alexBinos/ergonomic_split/README.md

# ergonomic_split
An ergonomic split keyboard
