alexBinos/ergonomic_split/Mechanical/DXF/ergonomic_split_right-B_CrtYd.dxf

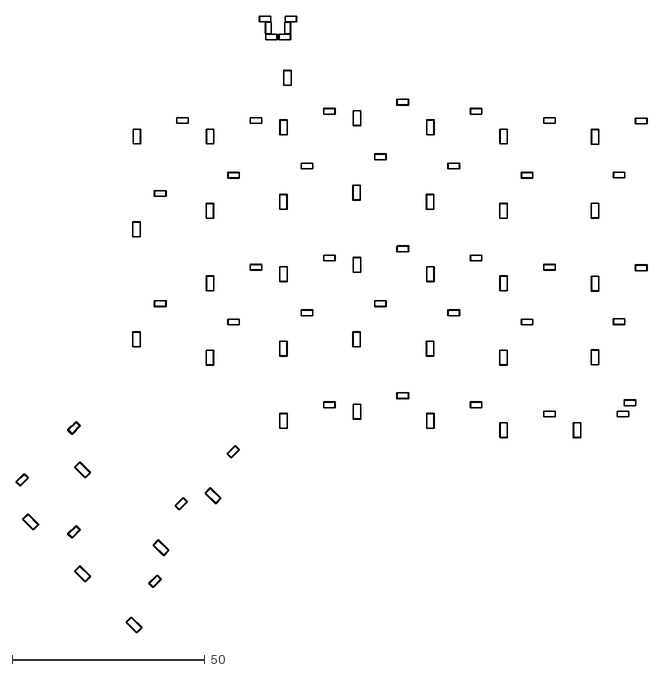
[picture p1: CAD file, 2022-08-09]
Mechanical/DXF/ergonomic_split_right-B_CrtYd.dxf
163.8 x 160.1
