alexBinos/ergonomic_split/Mechanical/left/ergonomic_split_left_key_frame.STL

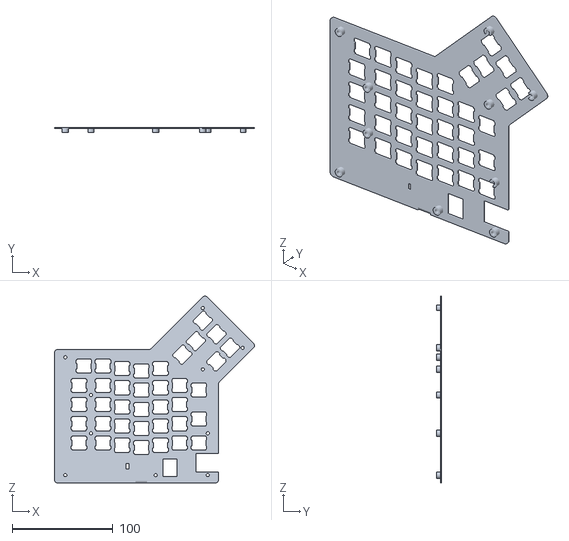
[picture p2: CAD file, 2022-08-22]
Mechanical/left/ergonomic_split_left_key_frame.STL
198.7 x 5.00 x 185.6
