alexBinos/ergonomic_split/Mechanical/switch.DXF

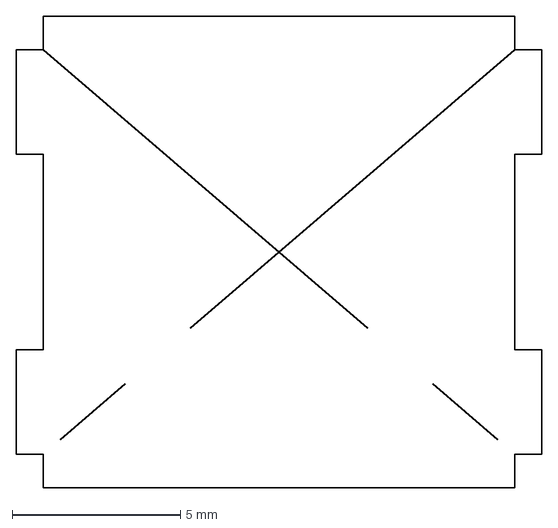
[picture p3: CAD file, 2022-08-06]
Mechanical/switch.DXF
15.6 x 14.0 mm
