alexBinos/ergonomic_split/Mechanical/DXF/ergonomic_split_right-PTH-drl_map.dxf

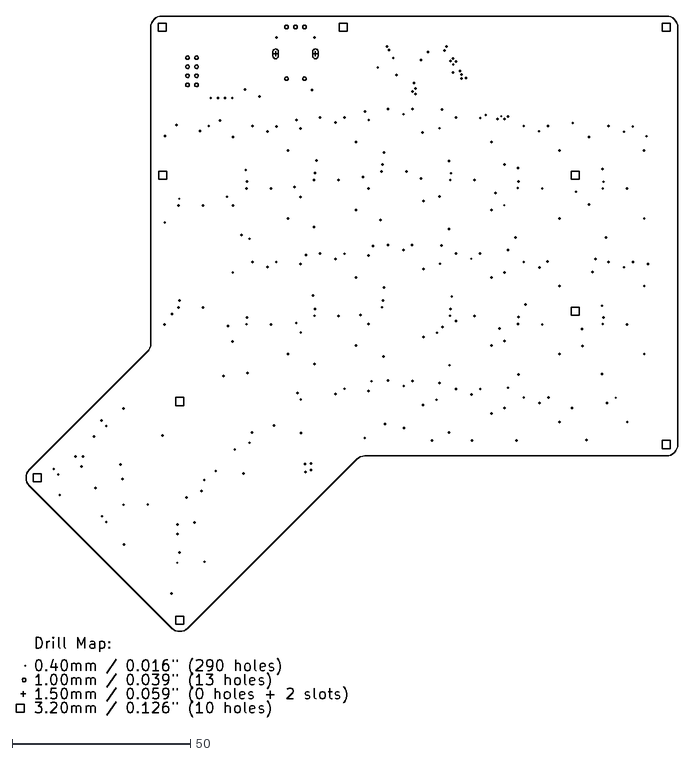
[picture p4: CAD file, 2022-08-09]
Mechanical/DXF/ergonomic_split_right-PTH-drl_map.dxf
185.7 x 196.8
