alexBinos/ergonomic_split/Mechanical/ergonomic_split_stand.STL

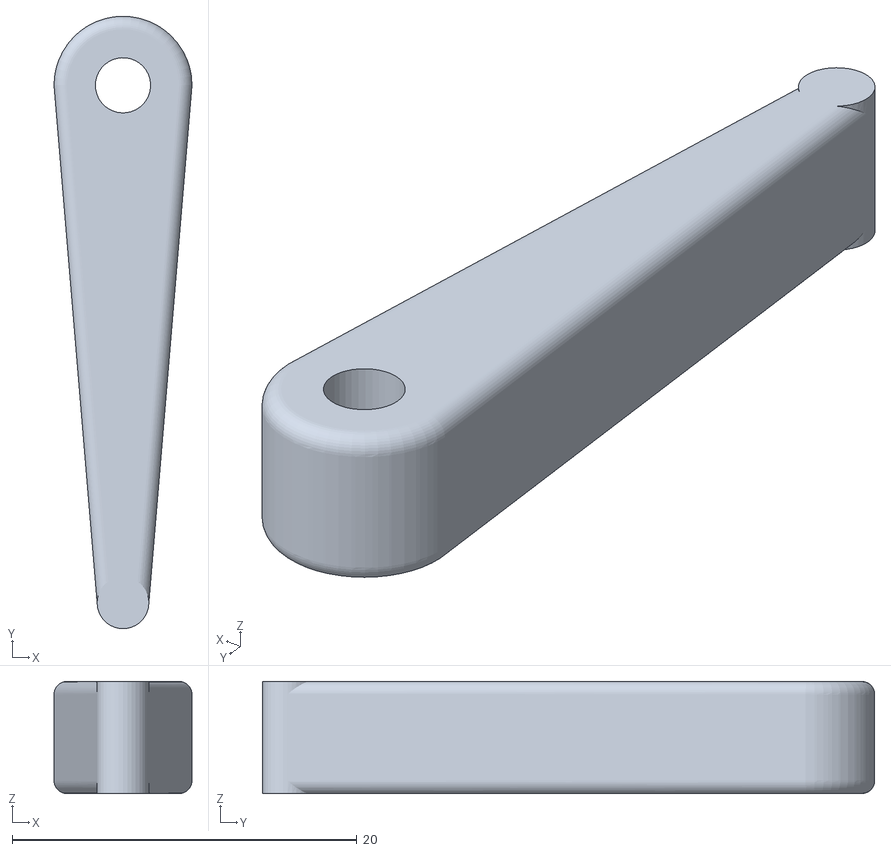
[picture p5: CAD file, 2022-08-06]
Mechanical/ergonomic_split_stand.STL
8.00 x 35.5 x 6.50
