alexBinos/ergonomic_split/Mechanical/left/ergonomic_split_left_case.STL

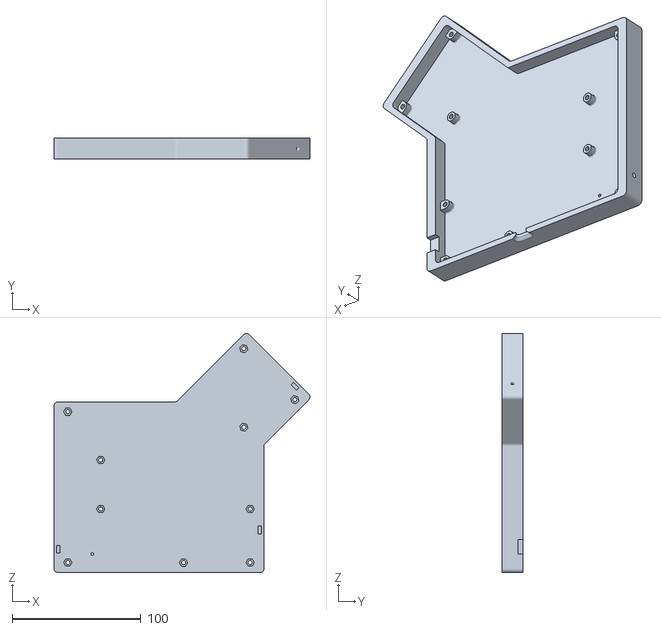
[picture p6: CAD file, 2022-08-13]
Mechanical/left/ergonomic_split_left_case.STL
198.7 x 16.0 x 185.6
