alexBinos/ergonomic_split/Mechanical/DXF/ergonomic_split_right-F_CrtYd.dxf

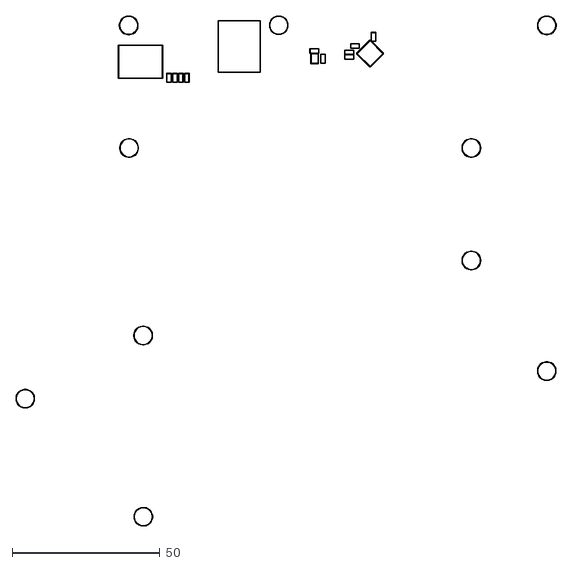
[picture p7: CAD file, 2022-08-09]
Mechanical/DXF/ergonomic_split_right-F_CrtYd.dxf
182.9 x 172.7
