alexBinos/ergonomic_split/Mechanical/DXF/ergonomic_split_right-Dwgs_User.dxf

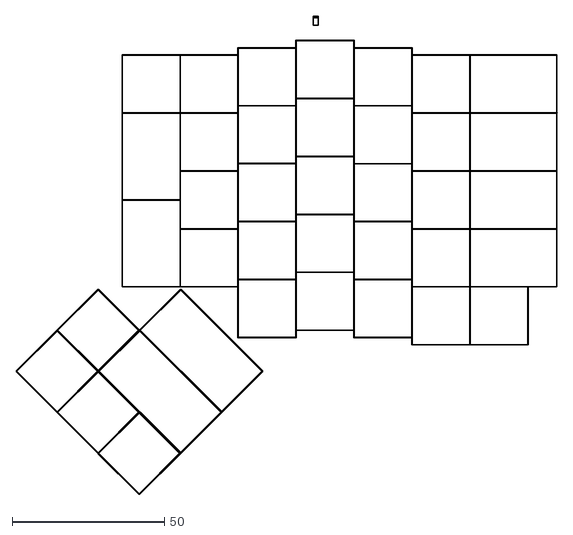
[picture p8: CAD file, 2022-08-09]
Mechanical/DXF/ergonomic_split_right-Dwgs_User.dxf
177.9 x 157.2
