alexBinos/ergonomic_split/Mechanical/DXF/ergonomic_split_right-Edge_Cuts.dxf

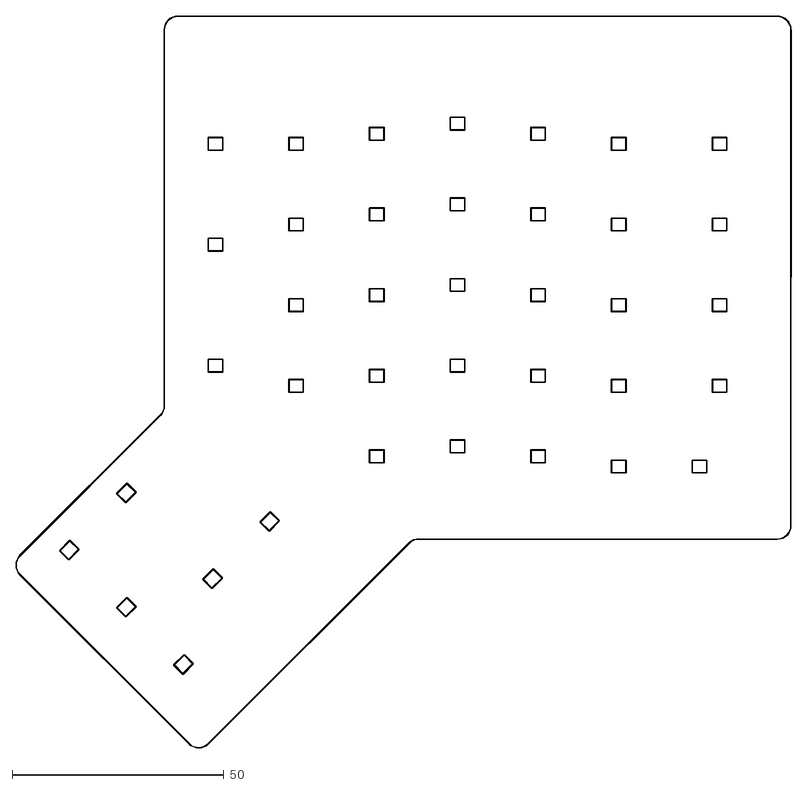
[picture p9: CAD file, 2022-08-09]
Mechanical/DXF/ergonomic_split_right-Edge_Cuts.dxf
183.0 x 172.8
