alexBinos/ergonomic_split/Mechanical/DXF/ergonomic_split_right-NPTH-drl_map.dxf

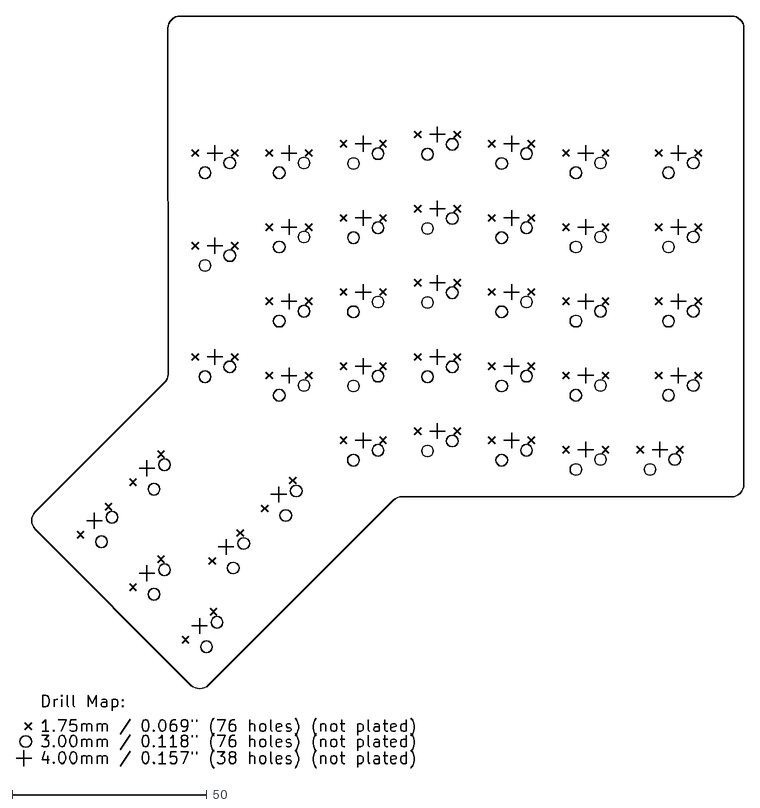
[picture p10: CAD file, 2022-08-09]
Mechanical/DXF/ergonomic_split_right-NPTH-drl_map.dxf
187.0 x 193.2
