alexBinos/ergonomic_split/Mechanical/DXF/ergonomic_split_left-F_CrtYd.dxf

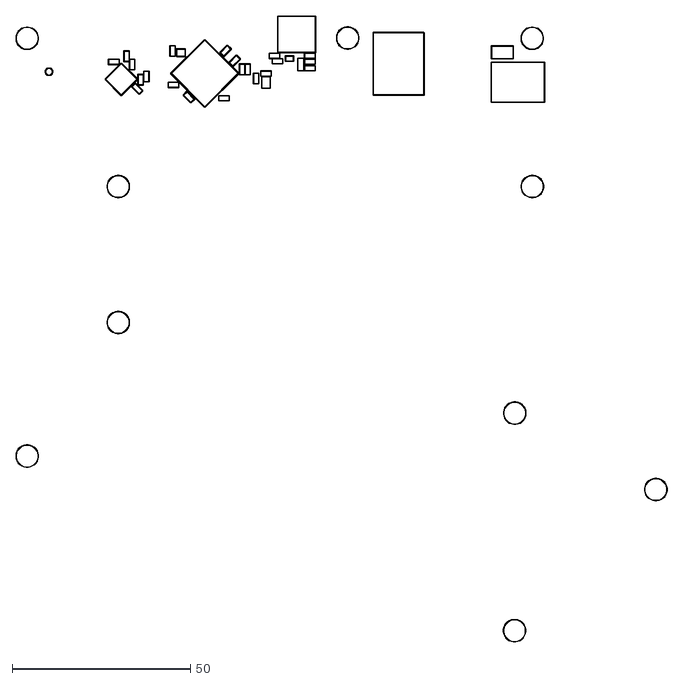
[picture p11: CAD file, 2022-07-26]
Mechanical/DXF/ergonomic_split_left-F_CrtYd.dxf
182.5 x 175.4
