alexBinos/ergonomic_split/Mechanical/DXF/ergonomic_split_left-PTH-drl_map.dxf

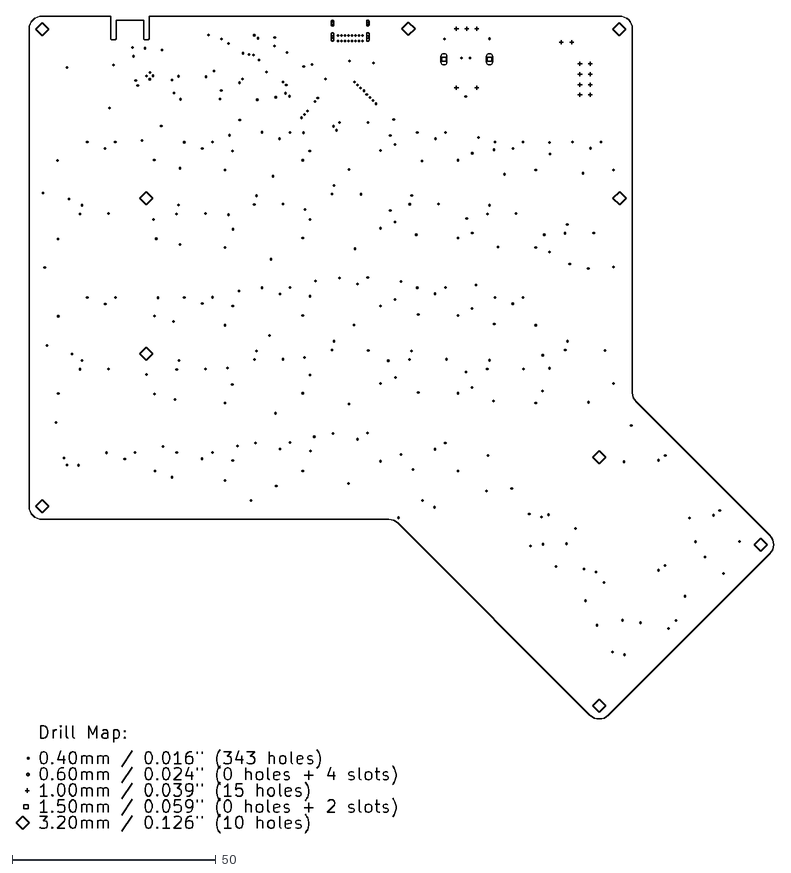
[picture p12: CAD file, 2022-07-26]
Mechanical/DXF/ergonomic_split_left-PTH-drl_map.dxf
186.1 x 200.4
