alexBinos/ergonomic_split/Mechanical/DXF/ergonomic_split_left-B_CrtYd.dxf

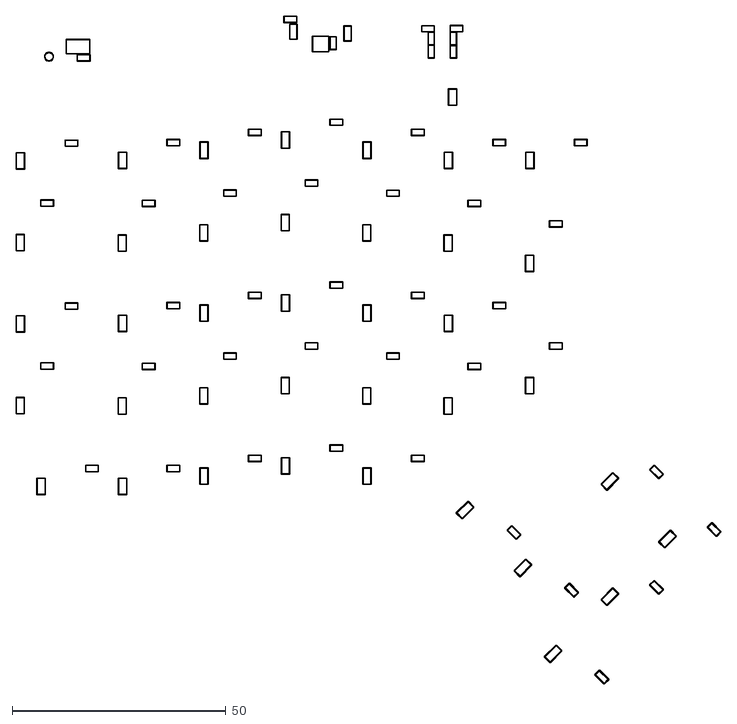
[picture p13: CAD file, 2022-07-26]
Mechanical/DXF/ergonomic_split_left-B_CrtYd.dxf
164.9 x 156.2
