alexBinos/ergonomic_split/Mechanical/DXF/ergonomic_split_left-NPTH-drl_map.dxf

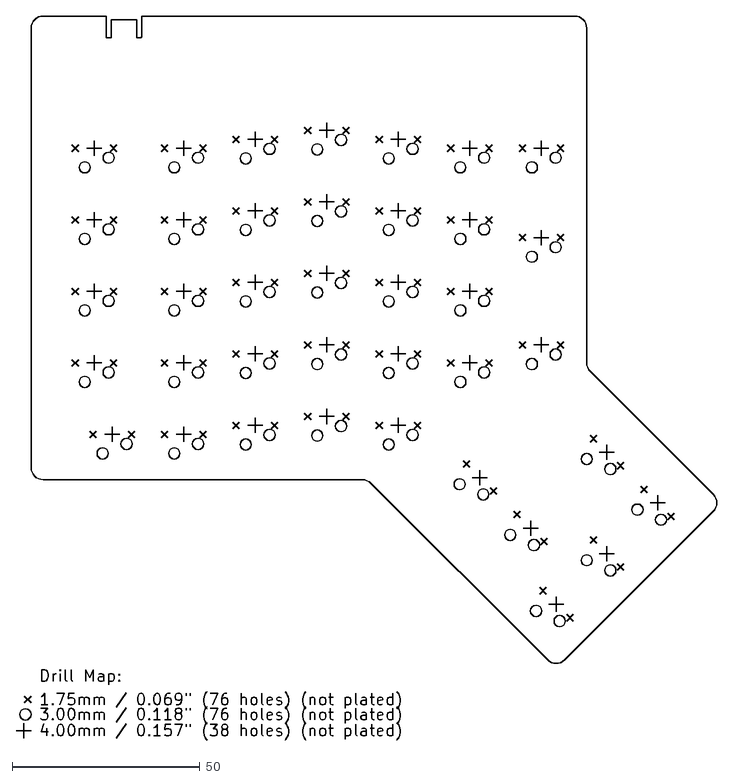
[picture p14: CAD file, 2022-07-26]
Mechanical/DXF/ergonomic_split_left-NPTH-drl_map.dxf
186.9 x 192.8
