alexBinos/ergonomic_split/Mechanical/DXF/ergonomic_split_left-Edge_Cuts.dxf

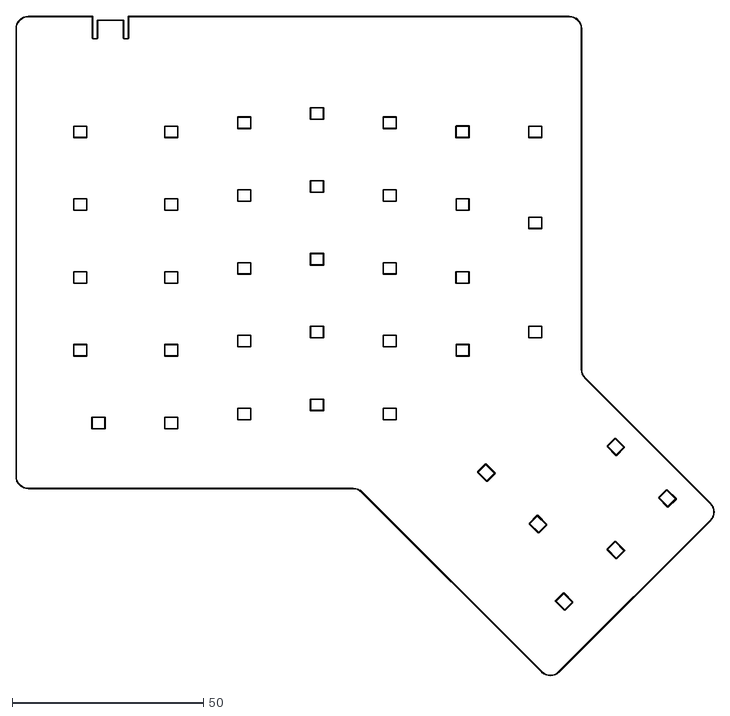
[picture p15: CAD file, 2022-07-26]
Mechanical/DXF/ergonomic_split_left-Edge_Cuts.dxf
182.6 x 172.5
