alexBinos/ergonomic_split/Mechanical/DXF/ergonomic_split_left-Dwgs_User.dxf

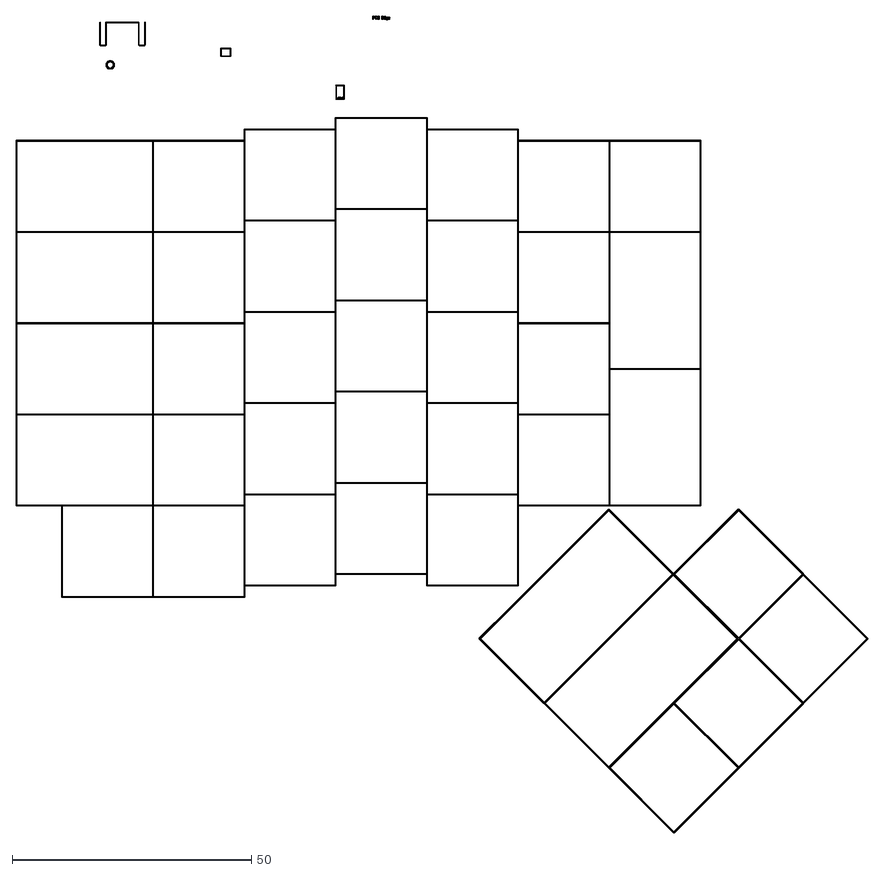
[picture p16: CAD file, 2022-07-26]
Mechanical/DXF/ergonomic_split_left-Dwgs_User.dxf
177.9 x 170.5
