alexBinos/ergonomic_split/(list of files, cad)

Other CAD files:
Mechanical/right/ergonomic_split_right_keyframe.STL
Mechanical/right/ergonomic_split_right_case.STL
