alexBinos/ergonomic_split/Documents/egonomic_split_right_sch.pdf

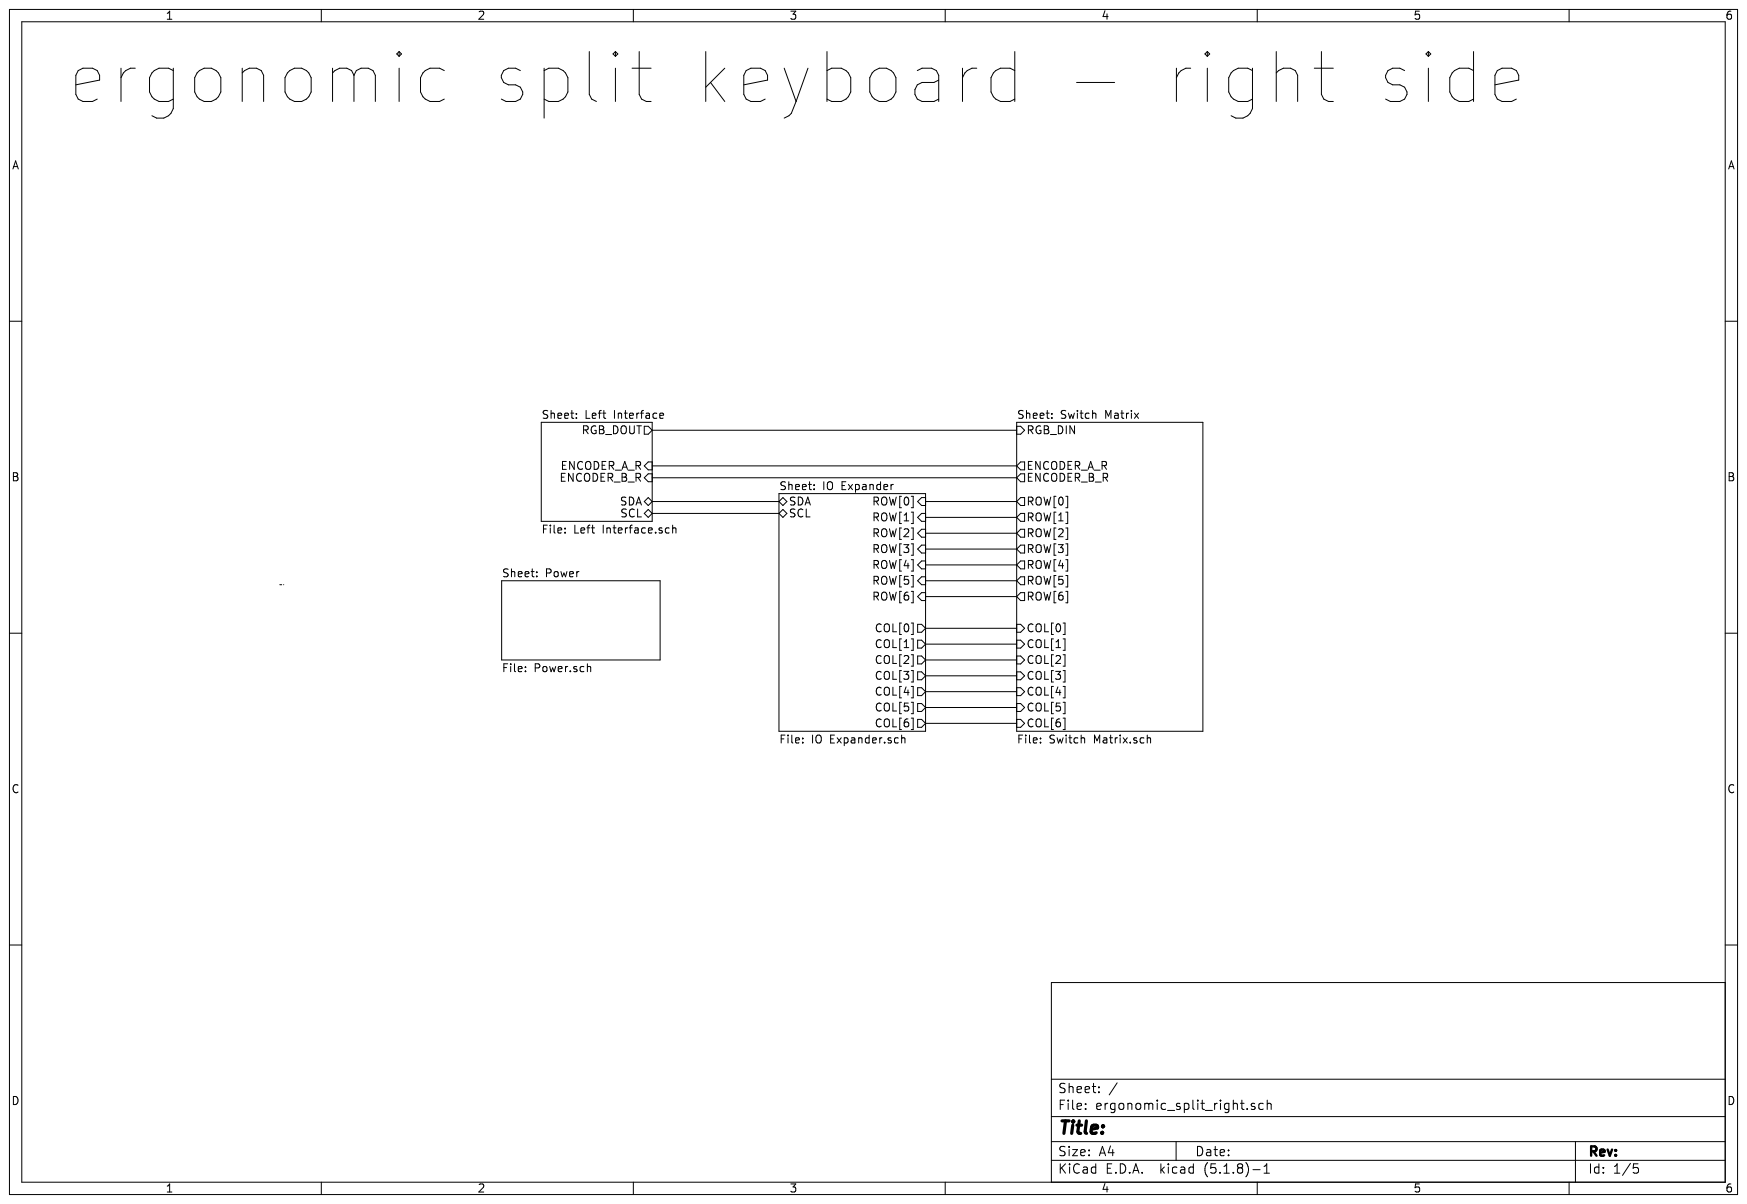
[picture p18: page 1]

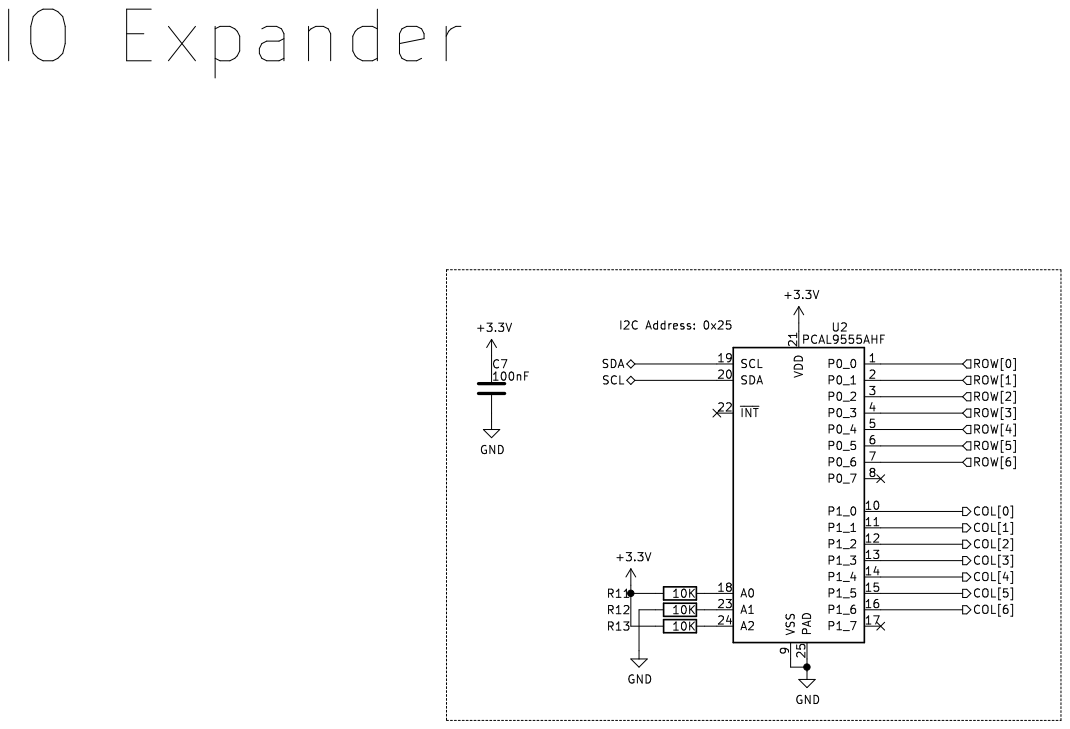
[picture p19: page 2]

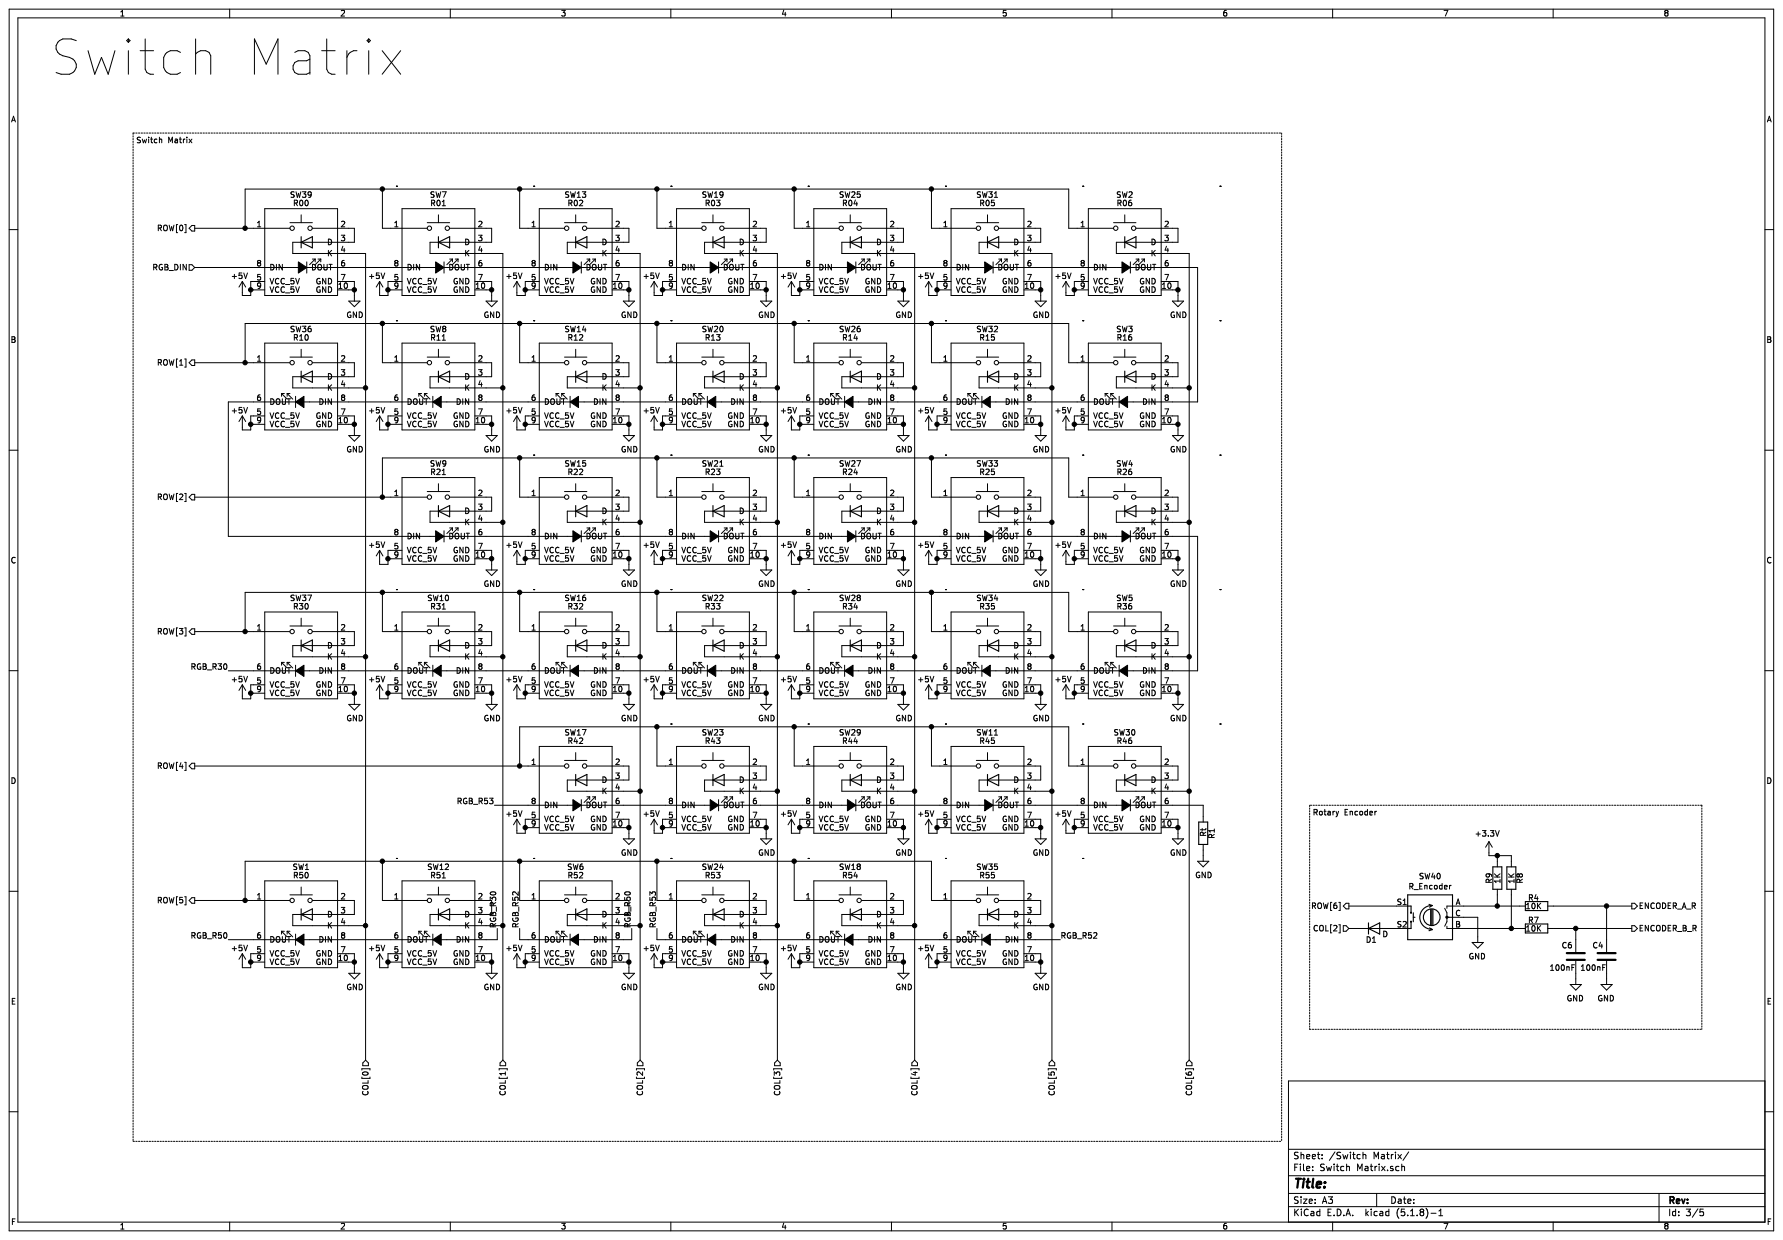
[picture p20: page 3]

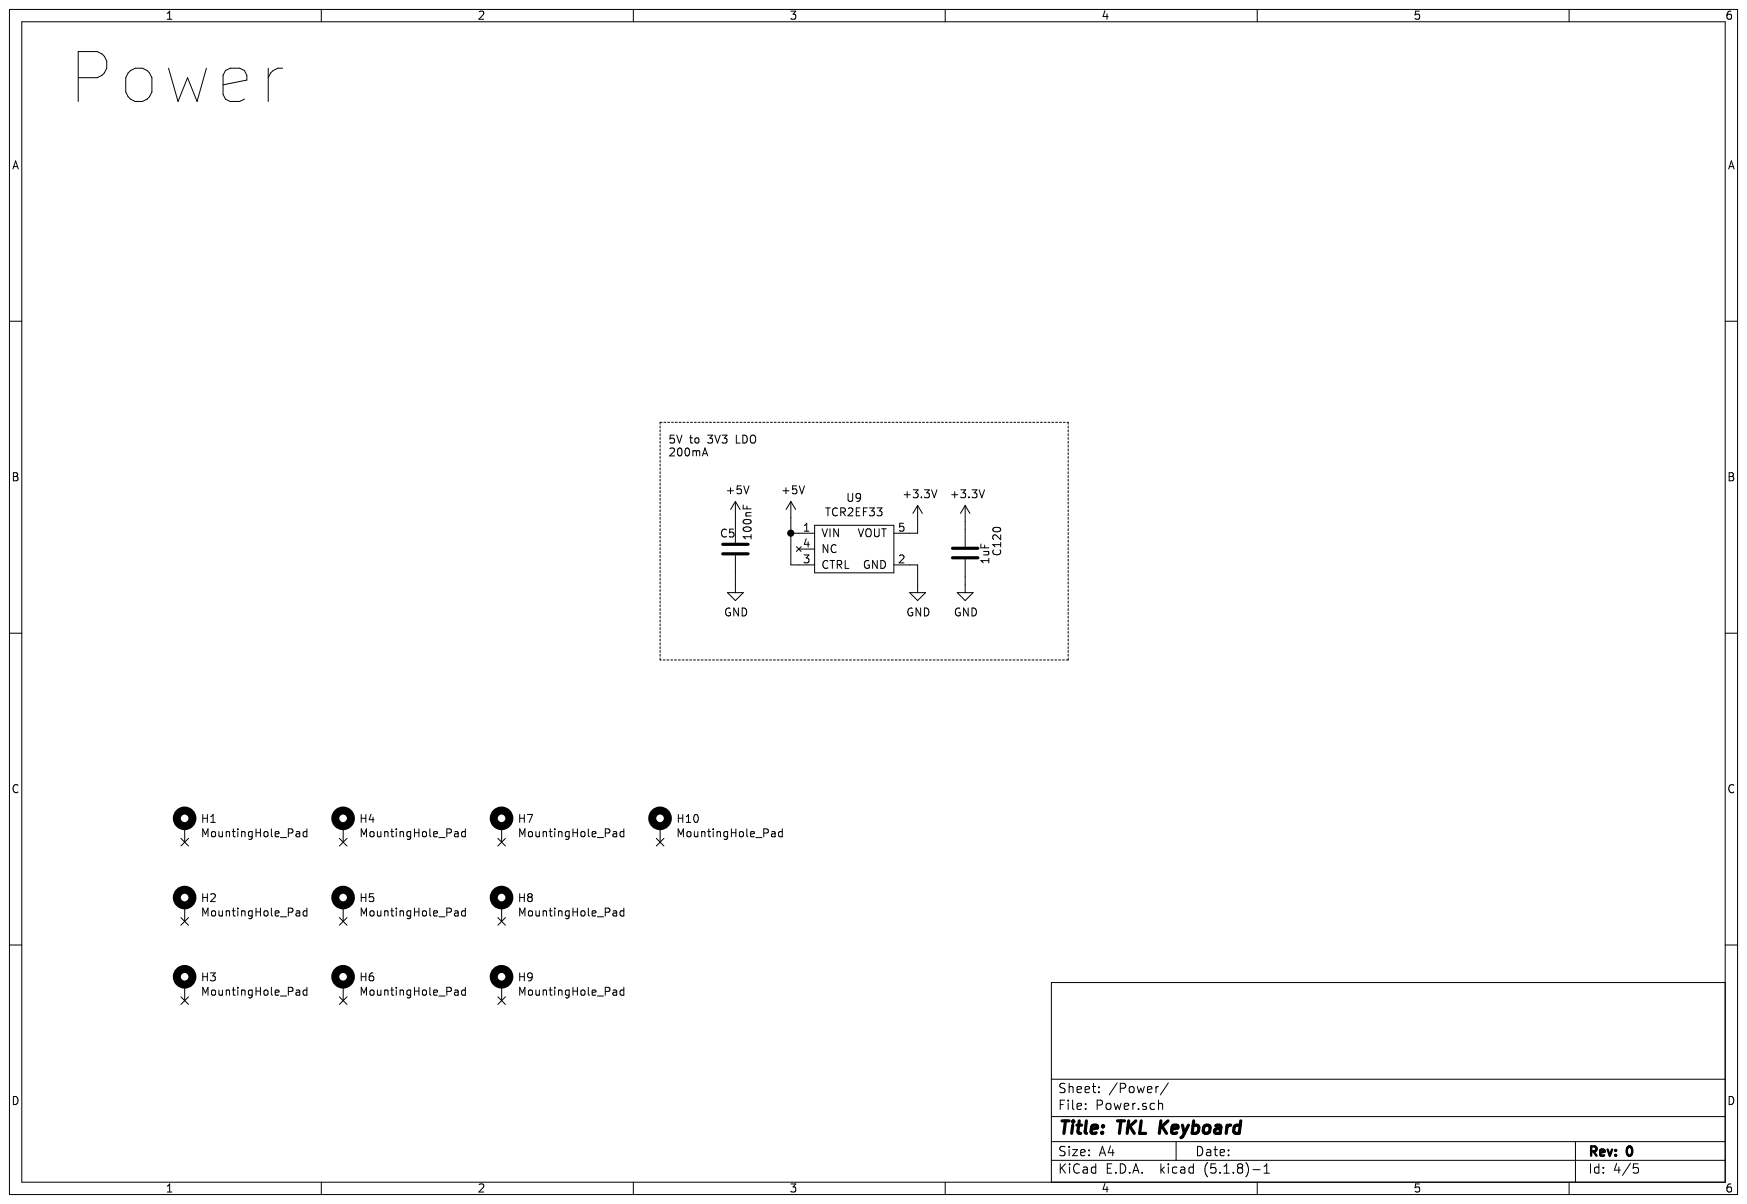
[picture p21: page 4]

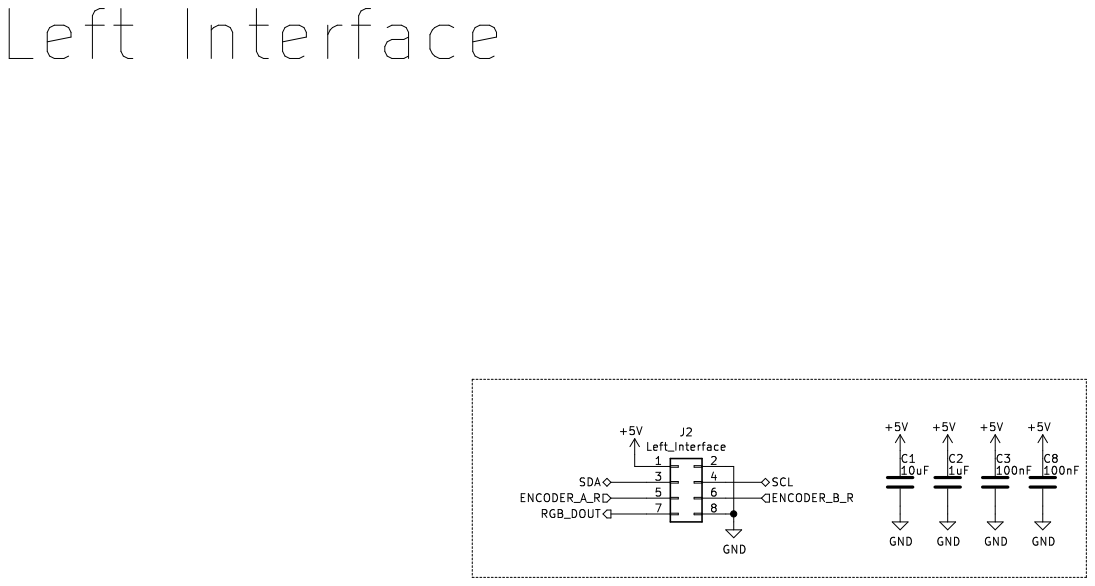
[picture p22: page 5]
