alexBinos/ergonomic_split/Hardware/v0/ergonomic_split_left/ergonomic_split_left.kicad_pcb

## KiCad design Hardware/v0/ergonomic_split_left/ergonomic_split_left.kicad_pcb (2022-07-26)

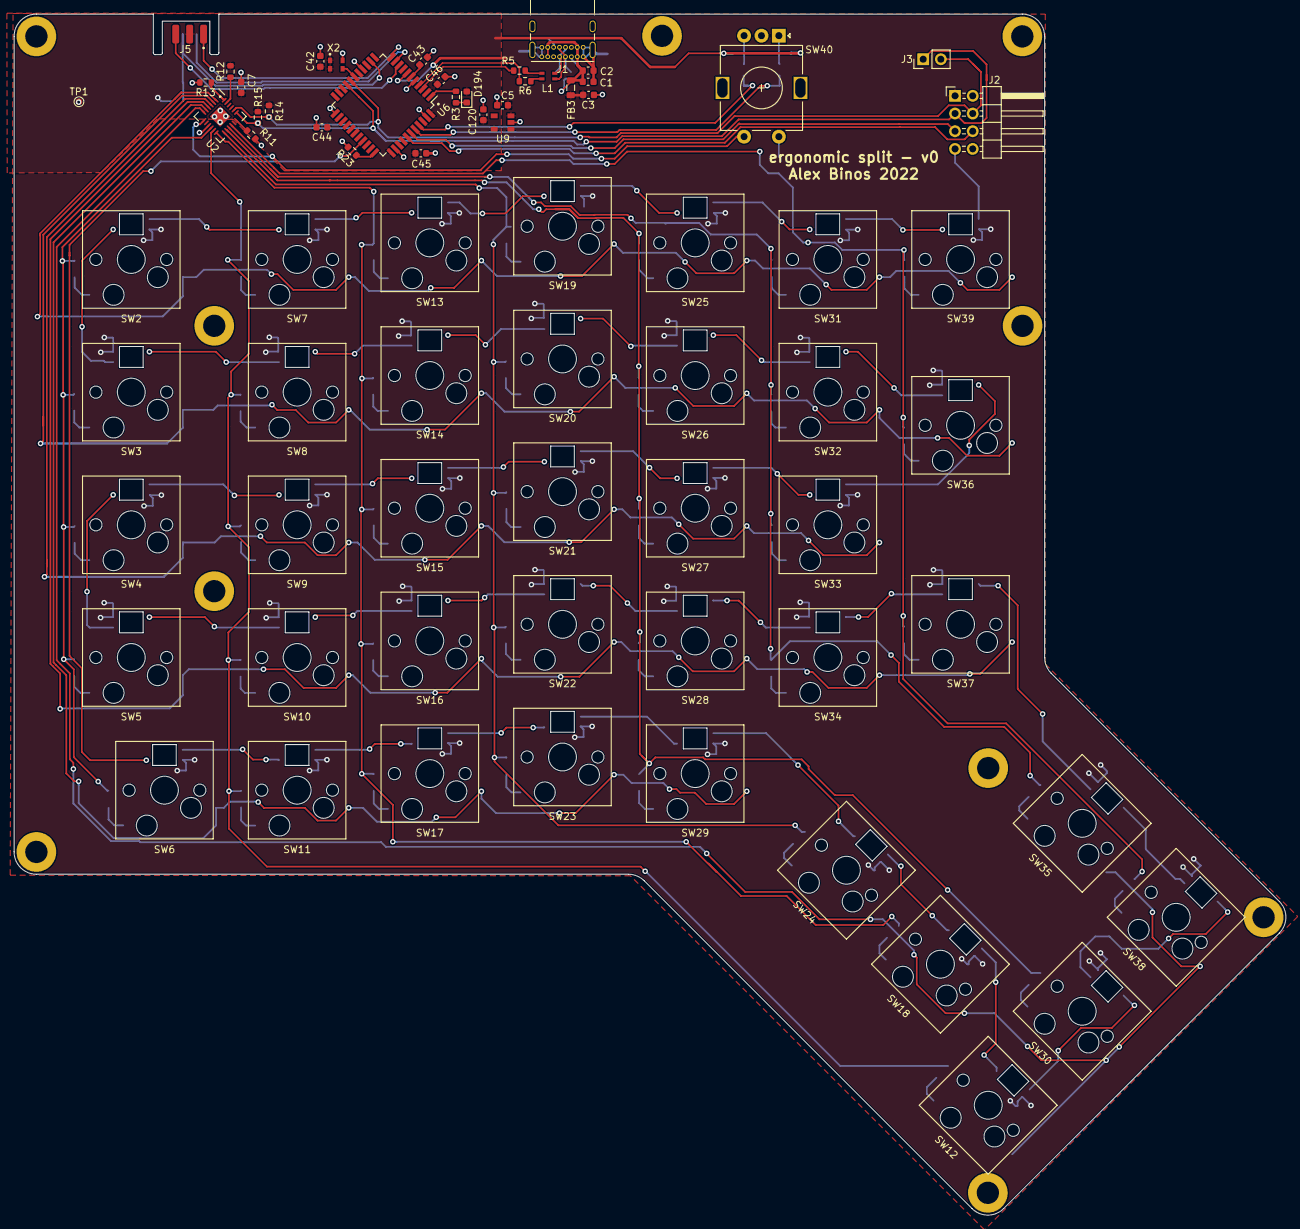
[picture p30: board ergonomic_split_left.kicad_pcb from above]

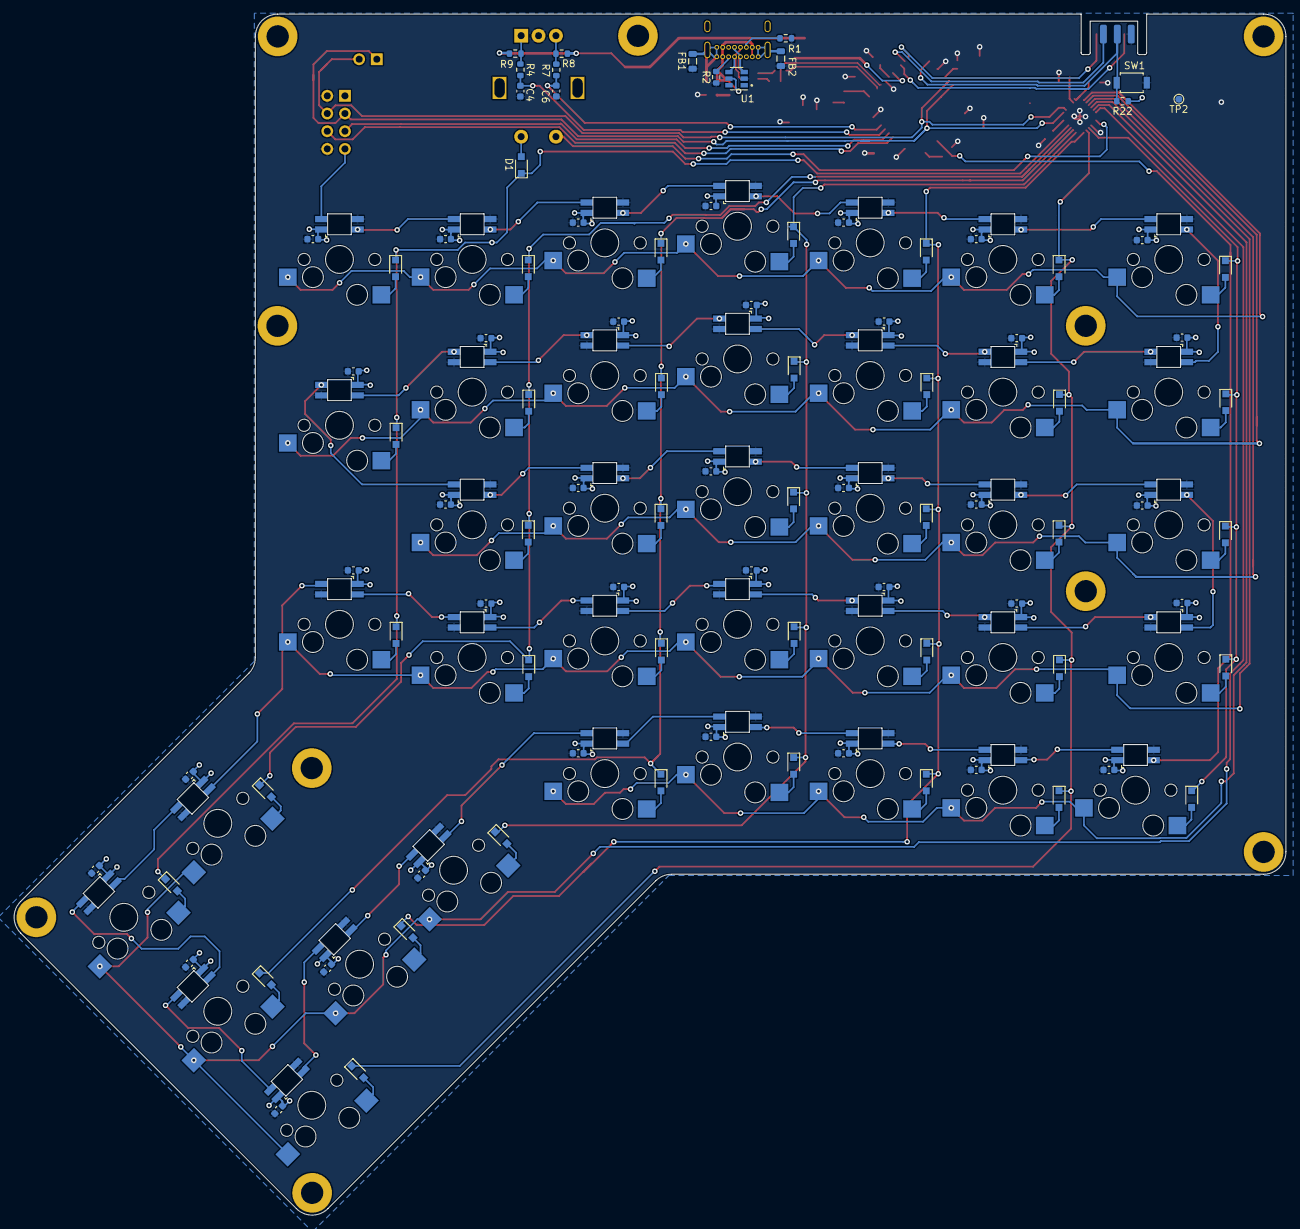
[picture p31: board ergonomic_split_left.kicad_pcb from below]

Board: 2 copper layers, 182.6 x 172.4 mm, 96 parts (15 on the bottom side), 125 nets.

Parts:
C1: 10uF; C_0603_1608Metric
C2, C43, C46, C120: 1uF; C_0603_1608Metric
C3, C4, C5, C6, C7, C42, C44, C45: 100nF; C_0603_1608Metric
D1: D; SOD323_HS
D194: LED; D_0603_1608Metric
FB1, FB2, FB3: Ferrite_Bead; L_0805_2012Metric
H1, H2, H3, H4, H5, H6, H7, H8, H9, H10: MountingHole_Pad; MountingHole_3.2mm_M3_ISO7380_Pad
J1: USB_C_Receptacle_USB2.0; USB_C_Receptacle_GCT_USB4085
J2: Right_Interface; PinHeader_2x04_P2.54mm_Horizontal
J3: Conn_01x02_Male; PinHeader_1x02_P2.54mm_Vertical
J5: Conn_02x03_Odd_Even; Conn_AVX_PCB_Edge_02x03
L1: L_Core_Iron_Coupled_1423; SMM2012E
R1, R2: 5K1; R_0603_1608Metric
R3: 330R; R_0603_1608Metric
R4, R7, R11, R12, R13, R22, R23: 10K; R_0603_1608Metric
R5, R6: 22R; R_0603_1608Metric
R8, R9: 1K; R_0603_1608Metric
R14, R15: 2K2; R_0603_1608Metric
SW1: SW_Push; SW_SPST_B3U-1000P
SW2: L00; CherryMX_1.50u_KailhSocket_Integrated_Reversed
SW3: L10; CherryMX_1.50u_KailhSocket_Integrated
SW4: L20; CherryMX_1.50u_KailhSocket_Integrated_Reversed
SW5: L30; CherryMX_1.50u_KailhSocket_Integrated
SW6: L40; CherryMX_1.00u_KailhSocket_Integrated_Reversed
SW7: L01; CherryMX_1.00u_KailhSocket_Integrated_Reversed
SW8: L11; CherryMX_1.00u_KailhSocket_Integrated
SW9: L21; CherryMX_1.00u_KailhSocket_Integrated_Reversed
SW10: L31; CherryMX_1.00u_KailhSocket_Integrated
SW11: L41; CherryMX_1.00u_KailhSocket_Integrated_Reversed
SW12: L51; CherryMX_1.00u_KailhSocket_Integrated_Reversed
SW13: L02; CherryMX_1.00u_KailhSocket_Integrated_Reversed
SW14: L12; CherryMX_1.00u_KailhSocket_Integrated
SW15: L22; CherryMX_1.00u_KailhSocket_Integrated_Reversed
SW16: L32; CherryMX_1.00u_KailhSocket_Integrated
SW17: L42; CherryMX_1.00u_KailhSocket_Integrated_Reversed
SW18: L52; CherryMX_2.00u_KailhSocket_Integrated_Vertical_Reversed
SW19: L03; CherryMX_1.00u_KailhSocket_Integrated_Reversed
SW20: L13; CherryMX_1.00u_KailhSocket_Integrated
SW21: L23; CherryMX_1.00u_KailhSocket_Integrated_Reversed
SW22: L33; CherryMX_1.00u_KailhSocket_Integrated
SW23: L43; CherryMX_1.00u_KailhSocket_Integrated_Reversed
SW24: L53; CherryMX_2.00u_KailhSocket_Integrated_Vertical_Reversed
SW25: L04; CherryMX_1.00u_KailhSocket_Integrated_Reversed
SW26: L14; CherryMX_1.00u_KailhSocket_Integrated
SW27: L24; CherryMX_1.00u_KailhSocket_Integrated_Reversed
SW28: L34; CherryMX_1.00u_KailhSocket_Integrated
SW29: L44; CherryMX_1.00u_KailhSocket_Integrated_Reversed
SW30: L54; CherryMX_1.00u_KailhSocket_Integrated
SW31: L05; CherryMX_1.00u_KailhSocket_Integrated_Reversed
SW32: L15; CherryMX_1.00u_KailhSocket_Integrated
SW33: L25; CherryMX_1.00u_KailhSocket_Integrated_Reversed
SW34: L35; CherryMX_1.00u_KailhSocket_Integrated
SW35: L55; CherryMX_1.00u_KailhSocket_Integrated
SW36: L16; CherryMX_1.50u_KailhSocket_Integrated_Vertical
SW37: L36; CherryMX_1.50u_KailhSocket_Integrated_Vertical
SW38: L56; CherryMX_1.00u_KailhSocket_Integrated
SW39: L06; CherryMX_1.00u_KailhSocket_Integrated_Reversed
SW40: L_Encoder; RotaryEncoder_Alps_EC11E-Switch_Vertical_H20mm
TP1, TP2: TestPoint; TestPoint_Pad_D1.0mm
U1: SRV05-4; SOT-23-6
U2: PCAL9555AHF; QFN-24_EP_5x5_Pitch0.5mm
U6: ATmega32U4-AU; TQFP-44_10x10mm_P0.8mm
U9: TCR2EF33; TCR2EF33_SOT25
X2: KC2016K

Connections:
+3V3: C7.1, C42.1, C44.1, C45.1, C46.1, C120.1, D194.2, J5.2, R8.2, R9.2, R12.2, R14.1, R15.1, R22.1, U2.21, U6.2, U6.14, U6.24, U6.34, U6.42, U6.44, U9.5, X2.1, X2.4
+5V: C3.1, C5.1, FB3.1, J2.1, SW2.5, SW2.9, SW3.5, SW3.9, SW4.5, SW4.9, SW5.5, SW5.9, SW6.5, SW6.9, SW7.5, SW7.9, SW8.5, SW8.9, SW9.5, SW9.9, SW10.5, SW10.9, SW11.5, SW11.9, SW12.5, SW12.9, SW13.5, SW13.9, SW14.5, SW14.9, SW15.5, SW15.9, SW16.5, SW16.9, SW17.5, SW17.9, SW18.5, SW18.9, SW19.5, SW19.9, SW20.5, SW20.9, SW21.5, SW21.9, SW22.5, SW22.9, SW23.5, SW23.9, SW24.5, SW24.9, SW25.5, SW25.9, SW26.5, SW26.9, SW27.5, SW27.9, SW28.5, SW28.9, SW29.5, SW29.9, SW30.5, SW30.9, SW31.5, SW31.9, SW32.5, SW32.9, SW33.5, SW33.9, SW34.5, SW34.9, SW35.5, SW35.9, SW36.5, SW36.9, SW37.5, SW37.9, SW38.5, SW38.9, SW39.5, SW39.9, U6.7, U9.1, U9.3
/IO Expander/COL[0]: SW2.4, SW3.4, SW4.4, SW5.4, SW6.4, U2.10
/IO Expander/COL[1]: SW7.4, SW8.4, SW9.4, SW10.4, SW11.4, SW12.4, U2.11
/IO Expander/COL[2]: SW13.4, SW14.4, SW15.4, SW16.4, SW17.4, SW18.4, U2.12
/IO Expander/COL[3]: SW19.4, SW20.4, SW21.4, SW22.4, SW23.4, SW24.4, U2.13
/IO Expander/COL[4]: SW25.4, SW26.4, SW27.4, SW28.4, SW29.4, SW30.4, U2.14
/IO Expander/COL[5]: SW31.4, SW32.4, SW33.4, SW34.4, SW35.4, U2.15
/IO Expander/COL[6]: D1.1, SW36.4, SW37.4, SW38.4, SW39.4, U2.16
/IO Expander/ROW[0]: SW2.1, SW7.1, SW13.1, SW19.1, SW25.1, SW31.1, SW39.1, U2.1
/IO Expander/ROW[1]: SW3.1, SW8.1, SW14.1, SW20.1, SW26.1, SW32.1, SW36.1, U2.2
/IO Expander/ROW[2]: SW4.1, SW9.1, SW15.1, SW21.1, SW27.1, SW33.1, U2.3
/IO Expander/ROW[3]: SW5.1, SW10.1, SW16.1, SW22.1, SW28.1, SW34.1, SW37.1, U2.4
/IO Expander/ROW[4]: SW6.1, SW11.1, SW17.1, SW23.1, SW29.1, U2.5
/IO Expander/ROW[5]: SW12.1, SW18.1, SW24.1, SW30.1, SW35.1, SW38.1, U2.6
/IO Expander/ROW[6]: SW40.S1, U2.7
/IO Expander/SCL: J2.4, J3.2, R14.2, U2.20, U6.18
/IO Expander/SDA: J2.3, J3.1, R15.2, U2.19, U6.19
/Right Interface/ENCODER_A_R: J2.5, U6.39
/Right Interface/ENCODER_B_R: J2.6, U6.38
/Right Interface/RGB_DIN: J2.7, SW39.6
/Switch Matrix/ENCODER_A_L: C4.1, R4.2, U6.40
/Switch Matrix/ENCODER_B_L: C6.1, R7.2, U6.41
/Switch Matrix/RGB_DIN: SW6.8, U6.30
/Switch Matrix/RGB_L44: SW24.8, SW29.6
/Switch Matrix/RGB_L51: SW12.6, SW30.8
/Switch Matrix/RGB_L54: SW30.6, SW38.8
/Switch Matrix/RGB_L55: SW35.6, SW37.8
/USB_UPSTREAM/CD+: J1.A6, J1.B6, L1.3, U1.4
/USB_UPSTREAM/CD-: J1.A7, J1.B7, L1.4, U1.3
/USB_UPSTREAM/D+: L1.2, R6.2
/USB_UPSTREAM/D-: L1.1, R5.2
/USB_UPSTREAM/USB+: R6.1, U6.4
/USB_UPSTREAM/USB-: R5.1, U6.3
/uController/MISO: J5.1, U6.11
/uController/MOSI: J5.4, U6.10
/uController/RST: J5.5, R22.2, SW1.1, U6.13
/uController/SCK: J5.3, U6.9
/uController/nCAPS_LED: R3.1, U6.1
GND: C3.2, C4.2, C5.2, C6.2, C7.2, C42.2, C43.2, C44.2, C45.2, C46.2, C120.2, FB1.1, FB2.1, J2.2, J2.8, J5.6, R1.1, R2.1, R11.2, R13.2, R23.2, SW1.2, SW2.7, SW2.10, SW3.7, SW3.10, SW4.7, SW4.10, SW5.7, SW5.10, SW6.7, SW6.10, SW7.7, SW7.10, SW8.7, SW8.10, SW9.7, SW9.10, SW10.7, SW10.10, SW11.7, SW11.10, SW12.7, SW12.10, SW13.7, SW13.10, SW14.7, SW14.10, SW15.7, SW15.10, SW16.7, SW16.10, SW17.7, SW17.10, SW18.7, SW18.10, SW19.7, SW19.10, SW20.7, SW20.10, SW21.7, SW21.10, SW22.7, SW22.10, SW23.7, SW23.10, SW24.7, SW24.10, SW25.7, SW25.10, SW26.7, SW26.10, SW27.7, SW27.10, SW28.7, SW28.10, SW29.7, SW29.10, SW30.7, SW30.10, SW31.7, SW31.10, SW32.7, SW32.10, SW33.7, SW33.10, SW34.7, SW34.10, SW35.7, SW35.10, SW36.7, SW36.10, SW37.7, SW37.10, SW38.7, SW38.10, SW39.7, SW39.10, SW40.C, TP1.1, TP2.1, U1.2, U2.9, U2.25, U6.5, U6.15, U6.23, U6.35, U6.43, U9.2, X2.2
unnamed: C1.2, C2.2, FB1.2, FB2.2, J1.A1, J1.A12, J1.B1, J1.B12, J1.S1
unnamed: C43.1, U6.6
unnamed: D1.2, SW40.S2
unnamed: D194.1, R3.2
unnamed: J1.A5, R2.2
unnamed: J1.B5, R1.2
unnamed: R4.1, R9.1, SW40.A
unnamed: R7.1, R8.1, SW40.B
unnamed: R11.1, U2.18
unnamed: R12.1, U2.23
unnamed: R13.1, U2.24
unnamed: R23.1, U6.33
unnamed: SW2.2, SW2.3
unnamed: SW2.6, SW7.8
unnamed: SW2.8, SW3.6
unnamed: SW3.2, SW3.3
unnamed: SW3.8, SW8.6
unnamed: SW4.2, SW4.3
unnamed: SW4.6, SW9.8
unnamed: SW4.8, SW5.6
unnamed: SW5.2, SW5.3
unnamed: SW6.2, SW6.3
unnamed: SW7.2, SW7.3
unnamed: SW8.2, SW8.3
unnamed: SW9.2, SW9.3
unnamed: SW10.2, SW10.3
unnamed: SW5.8, SW10.6
unnamed: SW10.8, SW16.6
unnamed: SW11.2, SW11.3
unnamed: SW11.6, SW17.8
unnamed: SW6.6, SW11.8
unnamed: SW12.2, SW12.3
unnamed: SW12.8, SW18.6
unnamed: SW13.2, SW13.3
unnamed: SW13.6, SW19.8
unnamed: SW7.6, SW13.8
unnamed: SW14.2, SW14.3
unnamed: SW8.8, SW14.6
unnamed: SW14.8, SW20.6
unnamed: SW15.2, SW15.3
unnamed: SW15.6, SW21.8
unnamed: SW9.6, SW15.8
unnamed: SW16.2, SW16.3
unnamed: SW16.8, SW22.6
unnamed: SW17.2, SW17.3
unnamed: SW17.6, SW23.8
unnamed: SW18.2, SW18.3
unnamed: SW18.8, SW24.6
unnamed: SW19.2, SW19.3
unnamed: SW19.6, SW25.8
unnamed: SW20.2, SW20.3
unnamed: SW20.8, SW26.6
unnamed: SW21.2, SW21.3
unnamed: SW21.6, SW27.8
unnamed: SW22.2, SW22.3
unnamed: SW22.8, SW28.6
unnamed: SW23.2, SW23.3
unnamed: SW23.6, SW29.8
unnamed: SW24.2, SW24.3
unnamed: SW25.2, SW25.3
unnamed: SW25.6, SW31.8
unnamed: SW26.2, SW26.3
unnamed: SW26.8, SW32.6
unnamed: SW27.2, SW27.3
unnamed: SW27.6, SW33.8
unnamed: SW28.2, SW28.3
unnamed: SW28.8, SW34.6
unnamed: SW29.2, SW29.3
unnamed: SW30.2, SW30.3
unnamed: SW31.2, SW31.3
unnamed: SW31.6, SW39.8
unnamed: SW32.2, SW32.3
unnamed: SW32.8, SW36.6
unnamed: SW33.2, SW33.3
unnamed: SW33.6, SW36.8
unnamed: SW34.2, SW34.3
unnamed: SW34.8, SW37.6
unnamed: SW35.2, SW35.3
unnamed: SW35.8, SW38.6
unnamed: SW36.2, SW36.3
unnamed: SW37.2, SW37.3
unnamed: SW38.2, SW38.3
unnamed: SW39.2, SW39.3
unnamed: U6.17, X2.3
VBUS: C1.1, C2.1, FB3.2, J1.A4, J1.A9, J1.B4, J1.B9, U1.5
