alexBinos/ergonomic_split/(commit log)

2022-06-04 Creating KiCAD project, starting schematic design
    [IO Expander.sch, LEDs.sch, Right Interface.sch, Switch Matrix.sch, Switches.sch, USB_UPSTREAM.sch, ergonomic_split_left.kicad_pcb, ergonomic_split_left.sch]
2022-06-04 Switch matrix placement
    [Switch Matrix.sch, ergonomic_split_left.kicad_pcb]
2022-06-04 Connecting schematic blocks, most sub-blocks done
    [IO Expander.sch, Power.sch, Right Interface.sch, Switch Matrix.sch, USB_UPSTREAM.sch, ergonomic_split_left.kicad_pcb, ergonomic_split_left.sch, uController.sch]
2022-06-04 Drawing board outline Basic placement done Adding rotary encoder to the switch matrix Adding mounting holes
    [IO Expander.sch, Power.sch, Switch Matrix.sch, ergonomic_split_left.kicad_pcb, ergonomic_split_left.sch]
2022-06-05 Adding power and ground planes Adding right interface USB C connector Pin swapping on ATMEGA
    [Power.sch, Right Interface.sch, Switch Matrix.sch, USB_UPSTREAM.sch, ergonomic_split_left.kicad_pcb, uController.sch]
2022-06-05 Debug connectors Adding I2C debug header Changed SPI programming header to edge mount Changed right interface connector to IDC Cleaning up schematic
    [IO Expander.sch, Right Interface.sch, Switch Matrix.sch, USB_UPSTREAM.sch, ergonomic_split_left.kicad_pcb, ergonomic_split_left.sch, uController.sch]
2022-06-05 Switch matrix and LEDs prelim routing
    [ergonomic_split_left.kicad_pcb]
2022-06-05 Prelim routing done
    [USB_UPSTREAM.sch, ergonomic_split_left.kicad_pcb, uController.sch]
2022-06-06 Moving board edges in to 0.1in from keyswitches
    [ergonomic_split_left.kicad_pcb]
2022-06-06 Fixing power planes and connector positions
    [ergonomic_split_left.kicad_pcb]
2022-06-06 Cleaning up routing
    [ergonomic_split_left.kicad_pcb, uController.sch]
2022-06-06 Passes DRC Fixed component clashes Fixed traces blocking 5V0 power plane
    [ergonomic_split_left.kicad_pcb]
2022-06-07 Creating blank KiCAD project for right side PCB
    [ergonomic_split_right.kicad_pcb, ergonomic_split_right.sch]
2022-06-07 High level schematic done
    [IO Expander.sch, Left Interface.sch, Power.sch, Right Interface.sch, Switch Matrix.sch, ergonomic_split_right.sch]
2022-06-08 Board outline, power planes and component placement
    [Switch Matrix.sch, ergonomic_split_right.kicad_pcb]
2022-06-08 Moving right interface connector
    [ergonomic_split_left.kicad_pcb]
2022-06-11 Right side prelim routing mostly done
    [Switch Matrix.sch, ergonomic_split_right.kicad_pcb]
2022-06-11 Cleaning routing, fixing 3V3 plane
    [ergonomic_split_right.kicad_pcb]
2022-06-11 Adding input caps on 5V0
    [Left Interface.sch, ergonomic_split_right.kicad_pcb]
2022-06-11 Cleaning up silk
    [ergonomic_split_left.kicad_pcb, ergonomic_split_right.kicad_pcb]
2022-07-03 Creating Arduino Uno project to test PCAL9555 functions
2022-07-09 Fixing board edge around edge connector causing STEP to not generate correctly. Adding 3D model for USB C connector
    [ergonomic_split_left.kicad_pcb]
2022-07-09 Updating component 3d models
    [ergonomic_split_left.kicad_pcb, ergonomic_split_right.kicad_pcb]
2022-07-09 Adding gerbers
    [ergonomic_split_left-B_Cu.gbr, ergonomic_split_left-B_Mask.gbr, ergonomic_split_left-B_Paste.gbr, ergonomic_split_left-B_SilkS.gbr, ergonomic_split_left-Edge_Cuts.gbr, ergonomic_split_left-F_Cu.gbr, ergonomic_split_left-F_Mask.gbr, ergonomic_split_left-F_Paste.gbr]
2022-07-09 Tidying last few traces
    [ergonomic_split_left.kicad_pcb, ergonomic_split_right.kicad_pcb]
2022-07-09 Schematic title page
    [ergonomic_split_left.sch, ergonomic_split_right.sch]
2022-07-09 V0 schematic PDFs
2022-07-24 Fixing right interface connector 3D model
    [ergonomic_split_left.kicad_pcb]
2022-07-25 Scanning algorithm working, adding RGB and caps leds
2022-07-26 Drawing around reset switch for mechanical
    [ergonomic_split_left.kicad_pcb]
2022-07-26 Adding left side DXFs
    [ergonomic_split_left-B_CrtYd.dxf, ergonomic_split_left-Dwgs_User.dxf, ergonomic_split_left-Edge_Cuts.dxf, ergonomic_split_left-NPTH-drl_map.dxf, ergonomic_split_left-PTH-drl_map.dxf]
2022-07-26 Front courtyard DXF
    [ergonomic_split_left-F_CrtYd.dxf]
2022-07-26 First pass of case
    [ergonomic_split_left_case.STL]
2022-08-06 Fixing USB connector and stand nut clearances
    [ergonomic_split_left_case.STL]
2022-08-06 Adding keyframe and stand STLs
    [ergonomic_split_left_key_frame.STL, ergonomic_split_stand.STL, switch.DXF]
2022-08-07 Right side mechanicals
    [ergonomic_split_right_case.STL, ergonomic_split_right_keyframe.STL]
2022-08-09 ICSP 6 pin debug header to edge connector adapter board
    [ICSP_edge_adapter-B_Cu.gbr, ICSP_edge_adapter-B_Mask.gbr, ICSP_edge_adapter-B_Paste.gbr, ICSP_edge_adapter-B_SilkS.gbr, ICSP_edge_adapter-Edge_Cuts.gbr, ICSP_edge_adapter-F_Cu.gbr, ICSP_edge_adapter-F_Mask.gbr, ICSP_edge_adapter-F_Paste.gbr]
2022-08-09 Right side DXFs
    [ergonomic_split_right-B_CrtYd.dxf, ergonomic_split_right-Dwgs_User.dxf, ergonomic_split_right-Edge_Cuts.dxf, ergonomic_split_right-F_CrtYd.dxf, ergonomic_split_right-NPTH-drl_map.dxf, ergonomic_split_right-PTH-drl_map.dxf]
2022-08-10 Fixing stand cutouts
    [ergonomic_split_left_case.STL]
2022-08-13 Fixing caps LED and reset cutouts
    [ergonomic_split_left_case.STL, ergonomic_split_left_key_frame.STL]
2022-08-22 Changing thickness to 1.2mm, minor fixes
    [ergonomic_split_left_key_frame.STL, ergonomic_split_right_keyframe.STL]
2022-09-11 Adding i2c fix image
2022-09-24 Fixing keymap errors, adding config file
    [config.h]
2022-10-16 Fixing right side keyframe width
    [ergonomic_split_right_keyframe.STL]
2022-10-24 Adding left encoder
